OpenRemise/ESP32S3Board/bom.xlsx

 |  |  | ESP32S3Board PCS BOM
Item # | *Designator | *Qty | Manufacturer | *Mfg Part # | Description / Value | *Package/Footprint | Type | Your Instructions / Notes
1 | C1, C2, C5, C6, C7 | 5 | Samsung Electro-Mechanics | CL05B104KB54PNC | CAP CER 0.1UF 50V X7R 0402 | 0402 | SMD
2 | C3 | 1 | Nichicon | UCL1V101MCL6GS | CAP ALUM 100UF 20% 35V SMD | 6.60x6.60mm | SMD
3 | C4 | 1 | Samsung Electro-Mechanics | CL31B475KBHNFNE | CAP CER 4.7UF 50V X7R 1206 | 1206 | SMD
4 | C8, C9 | 2 | TDK Corporation | C3216X7S0J476M160AC | CAP CER 47UF 6.3V X7S 1206 | 1206 | SMD
5 | D1 | 1 | STMicroelectronics | ESDA6V1BC6 | TVS DIODE 5VWM SOT23-6 | SOT-23-6 | SMD
6 | D2 | 1 | SunLED | XZMDK68W-2 | LED RED CLEAR CHIP SMD | 0402 | SMD
7 | D3 | 1 | Toshiba Semiconductor and Storage | CEZ30V,L3F | TVS DIODE 30VWM 47.5VC ESC | SOD-523 | SMD
8 | D4 | 1 | SunLED | XZVG68W-2 | LED GREEN CLEAR CHIP SMD | 0402 | SMD
9 | D5 | 1 | SunLED | XZFBA68W5MAV-3 | LED BLUE CLEAR 0402 SMD | 0402 | SMD
10 | J1, J3, J4, J5, J6 | 5 |  |  |  |  | THT | not fitted
11 | J2 | 1 | GCT | USB4105-GF-A-120 | CONN RCP USB2.0 TYP C 24P SMD RA |  | SMD/THT
12 | J7 | 1 | JST Sales America Inc. | SM04B-SRSS-TB(LF)(SN) | CONN HEADER SMD R/A 4POS 1MM | 4-SMD | SMD
13 | JP1 | 1 |  |  |  |  | SMD | not fitted
14 | L1 | 1 | Murata Electronics | LQM21PN4R7NGRD | FIXED IND 4.7UH 800MA 288MOHM SM | 0805 | SMD
15 | Q1 | 1 | onsemi | BC847BDW1T1G | TRANS 2NPN 45V 0.1A SC88/SC70-6 | SOT-363 | SMD
16 | R1, R2 | 2 | Stackpole Electronics Inc | RMCF0402FT5K10 | RES 5.1K OHM 1% 1/16W 0402 | 0402 | SMD
17 | R3, R7, R8, R10 | 4 | Delta Electronics/Cyntec | PFR05S-103-FNH | RES SMD 10 KOHM 1% 1/16W 0402 | 0402 | SMD
18 | R4, R5 | 2 | Vishay Dale | TNPW040214K3BEED | RES 14.3K OHM 0.1% 1/16W 0402 | 0402 | SMD
19 | R6 | 1 | Panasonic Electronic Components | ERA-2AEB471X | RES SMD 470 OHM 0.1% 1/16W 0402 | 0402 | SMD
20 | R9, R11, R13 | 3 | TE Connectivity Passive Product | CRGCQ0402F3K3 | RES 3.3K OHM 1% 1/16W 0402 | 0402 | SMD
21 | R12 | 1 | YAGEO | RC0402FR-07562RL | RES 562 OHM 1% 1/16W 0402 | 0402 | SMD
22 | R14 | 1 | YAGEO | RC0402FR-07422RL | RES 422 OHM 1% 1/16W 0402 | 0402 | SMD
23 | SW1, SW2 | 2 | Panasonic Electronic Components | EVP-BFAC1A000 | SWITCH TACTILE SPST-NO 0.02A 15V |  | SMD | not fitted
24 | U1 | 1 | Espressif Systems | ESP32-S3-WROOM-2-N32R8V | SMD MODULE, ESP32-S3R8 WITH 1.8V |  | SMD
25 | U2 | 1 | Diodes Incorporated | AP63205WU-7 | IC REG BUCK 5V 2A TSOT26 | SOT-23-6 | SMD
26 | U3 | 1 | Texas Instruments | TXS0102DCUR | IC TRANSLTR BIDIRECTIONAL 8VSSOP | 8-VSSOP | SMD
27 | U4 | 1 | Infineon Technologies | BTS4141NHUMA1 | IC PWR SWTCH N-CHAN 1:1 SOT223-4 | SOT223-4 | SMD
28 | U5 | 1 | Diodes Incorporated | AZ1117CR-3.3TRG1 | IC REG LINEAR 3.3V 1A SOT89 | SOT-89-3 | SMD
