OpenRemise/ESP32S3Board/esp32s3board.kicad_pcb

## KiCad design esp32s3board.kicad_pcb (2024-08-15)

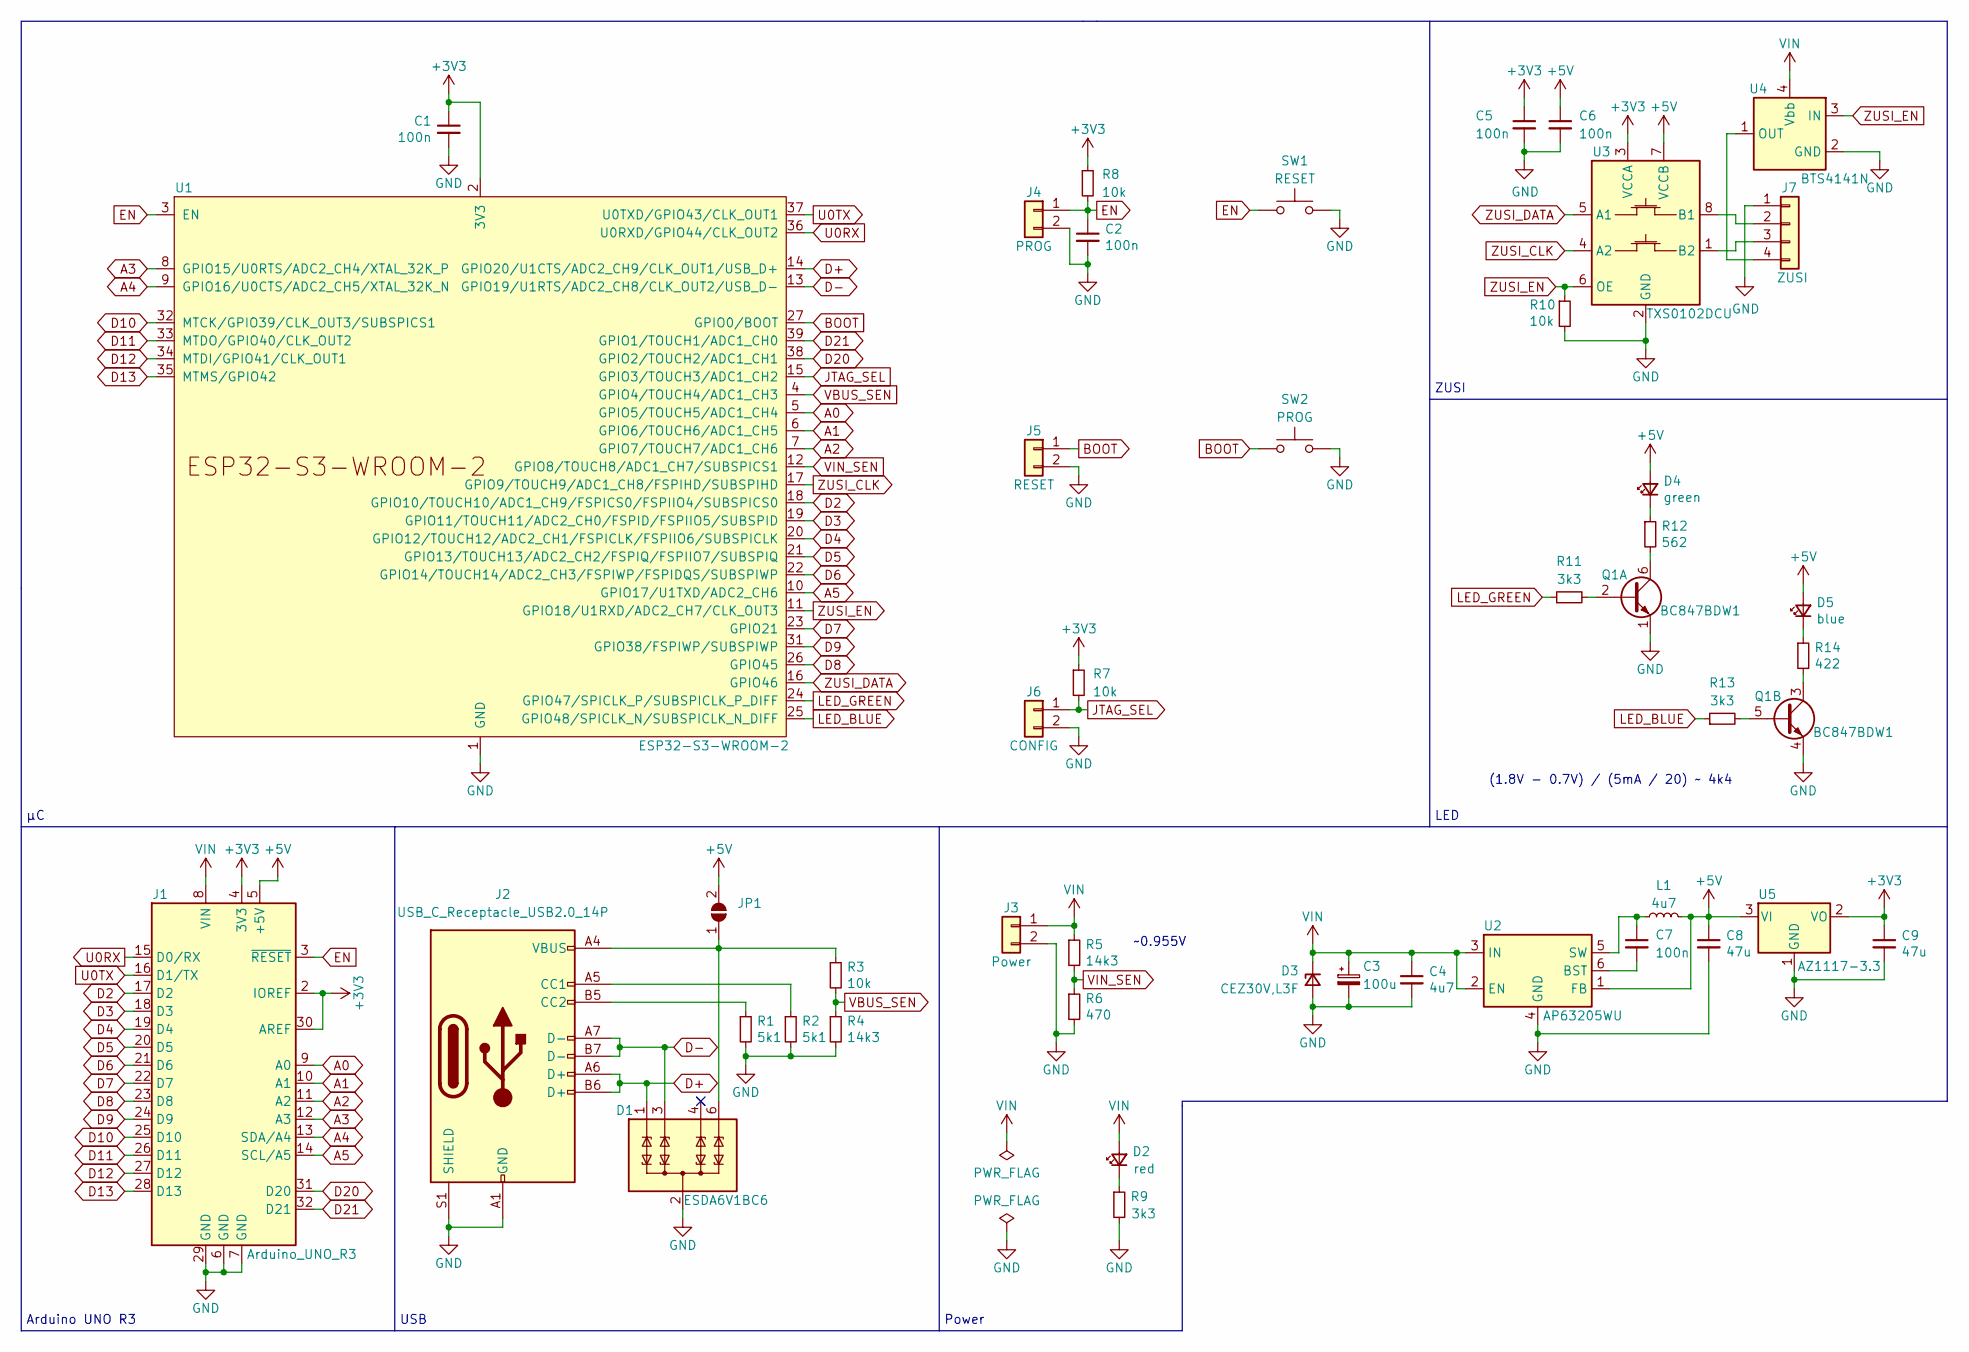
[picture p1: schematic esp32s3board.kicad_sch, OpenRemise ESP32S3Board]

Parts:
C1, C2, C5, C6, C7: 100n; C_0402_1005Metric
C3: 100u; CP_Elec_6.3x7.7
C4: 4u7; C_1206_3216Metric
C8, C9: 47u; C_1206_3216Metric
D1: ESDA6V1BC6; SOT-23-6
D2: red; D_0402_1005Metric
D3: CEZ30V,L3F; D_SOD-523
D4: green; D_0402_1005Metric
D5: blue; D_0402_1005Metric
J1: Arduino_UNO_R3; Arduino_UNO_R3_WithMountingHoles
J2: USB_C_Receptacle_USB2.0_14P; USB_C_Receptacle_GCT_USB4105-xx-A_16P_TopMnt_Horizontal
J3: Power; PinHeader_1x02_P2.54mm_Horizontal
J4: PROG; PinHeader_1x02_P2.54mm_Horizontal
J5: RESET; PinHeader_1x02_P2.54mm_Horizontal
J6: CONFIG; PinHeader_1x02_P2.54mm_Horizontal
J7: ZUSI; JST_SH_SM04B-SRSS-TB_1x04-1MP_P1.00mm_Horizontal
JP1: SolderJumper_2_Open; SolderJumper-2_P1.3mm_Open_Pad1.0x1.5mm
L1: 4u7; L_0805_2012Metric
Q1: BC847BDW1; SOT-363_SC-70-6
R1, R2: 5k1; R_0402_1005Metric
R3, R7, R8, R10: 10k; R_0402_1005Metric
R4, R5: 14k3; R_0402_1005Metric
R6: 470; R_0402_1005Metric
R9, R11, R13: 3k3; R_0402_1005Metric
R12: 562; R_0402_1005Metric
R14: 422; R_0402_1005Metric
SW1: RESET; SW_SPST_EVPBF
SW2: PROG; SW_SPST_EVPBF
U1: ESP32-S3-WROOM-2
U2: AP63205WU; TSOT-23-6
U3: TXS0102DCU; VSSOP-8_2.3x2mm_P0.5mm
U4: BTS4141N; SOT-223
U5: AZ1117-3.3; SOT-89-3

Connections:
+3V3: C1.1, C5.1, C9.1, J1.2 (IOREF), J1.4 (3V3), J1.30 (AREF), R7.1, R8.1, U1.2 (3V3), U3.3 (VCCA), U5.2 (VO)
+5V: C6.1, C8.1, D4.2 (A), D5.2 (A), J1.5 (+5V), JP1.2 (B), L1.2, U2.1 (FB), U3.7 (VCCB), U5.3 (VI)
A0: J1.9 (A0), U1.5 (GPIO5/TOUCH5/ADC1_CH4)
A1: J1.10 (A1), U1.6 (GPIO6/TOUCH6/ADC1_CH5)
A2: J1.11 (A2), U1.7 (GPIO7/TOUCH7/ADC1_CH6)
A3: J1.12 (A3), U1.8 (GPIO15/U0RTS/ADC2_CH4/XTAL_32K_P)
A4: J1.13 (SDA/A4), U1.9 (GPIO16/U0CTS/ADC2_CH5/XTAL_32K_N)
A5: J1.14 (SCL/A5), U1.10 (GPIO17/U1TXD/ADC2_CH6)
BOOT: J5.1, SW2.1, U1.27 (GPIO0/BOOT)
D2: J1.17 (D2), U1.18 (GPIO10/TOUCH10/ADC1_CH9/FSPICS0/FSPIIO4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)
D3: J1.18 (D3), U1.19 (GPIO11/TOUCH11/ADC2_CH0/FSPID/FSPIIO5/S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)
D4: J1.19 (D4), U1.20 (GPIO12/TOUCH12/ADC2_CH1/FSPICLK/FSPIIO6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)
D5: J1.20 (D5), U1.21 (GPIO13/TOUCH13/ADC2_CH2/FSPIQ/FSPIIO7/S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)
D6: J1.21 (D6), U1.22 (GPIO14/TOUCH14/ADC2_CH3/FSPIWP/FSPIDQS/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)
D7: J1.22 (D7), U1.23 (GPIO21)
D8: J1.23 (D8), U1.26 (GPIO45)
D9: J1.24 (D9), U1.31 (GPIO38/FSPIWP/SUBSPIWP)
D10: J1.25 (D10), U1.32 (MTCK/GPIO39/CLK_OUT3/SUBSPICS1)
D11: J1.26 (D11), U1.33 (MTDO/GPIO40/CLK_OUT2)
D12: J1.27 (D12), U1.34 (MTDI/GPIO41/CLK_OUT1)
D13: J1.28 (D13), U1.35 (MTMS/GPIO42)
D20: J1.31 (D20), U1.38 (GPIO2/TOUCH2/ADC1_CH1)
D21: J1.32 (D21), U1.39 (GPIO1/TOUCH1/ADC1_CH0)
D+: D1.1 (TVS1), J2.A6 (D+), J2.B6 (D+), U1.14 (GPIO20/U1CTS/ADC2_CH9/CLK_OUT1/USB_D+)
D-: D1.3 (TVS2), J2.A7 (D-), J2.B7 (D-), U1.13 (GPIO19/U1RTS/ADC2_CH8/CLK_OUT2/USB_D-)
EN: C2.1, J1.3 (~RESET), J4.1, R8.2, SW1.1, U1.3 (EN)
GND: C1.2, C2.2, C3.2, C4.2, C5.2, C6.2, C8.2, C9.2, D1.2 (COM), D1.5 (COM), D3.2 (A), J1.6 (GND), J1.7 (GND), J1.29 (GND), J2.A1 (GND), J2.A12 (GND), J2.B1 (GND), J2.B12 (GND), J2.S1 (SHIELD), J3.2, J4.2, J5.2, J6.2, J7.1, Q1.1 (E1), Q1.4 (E2), R1.2, R2.2, R4.2, R6.2, R9.2, R10.2, SW1.2, SW2.2, U1.1 (GND), U1.40 (GND), U1.41 (GND), U2.4 (GND), U3.2 (GND), U4.2 (GND), U5.1 (GND)
JTAG_SEL: J6.1, R7.2, U1.15 (GPIO3/TOUCH3/ADC1_CH2)
LED_BLUE: R13.1, U1.25 (GPIO48/SPICLK_N/SUBSPICLK_N_DIFF)
LED_GREEN: R11.1, U1.24 (GPIO47/SPICLK_P/SUBSPICLK_P_DIFF)
unnamed: D1.6 (TVS4), J2.A4 (VBUS), J2.A9 (VBUS), J2.B4 (VBUS), J2.B9 (VBUS), JP1.1 (A), R3.1
unnamed: D2.1 (K), R9.1
unnamed: D4.1 (K), R12.1
unnamed: D5.1 (K), R14.1
unnamed: J2.A5 (CC1), R2.1
unnamed: J2.B5 (CC2), R1.1
unnamed: J7.2, U3.8 (B1)
unnamed: J7.3, U3.1 (B2)
unnamed: J7.4, U4.1 (OUT)
unnamed: Q1.2 (B1), R11.2
unnamed: Q1.6 (C1), R12.2
unnamed: Q1.5 (B2), R13.2
unnamed: Q1.3 (C2), R14.2
unnamed: C7.2, U2.6 (BST)
unnamed: C7.1, L1.1, U2.5 (SW)
U0RX: J1.15 (D0/RX), U1.36 (U0RXD/GPIO44/CLK_OUT2)
U0TX: J1.16 (D1/TX), U1.37 (U0TXD/GPIO43/CLK_OUT1)
VBUS_SEN: R3.2, R4.1, U1.4 (GPIO4/TOUCH4/ADC1_CH3)
VIN: C3.1, C4.1, D2.2 (A), D3.1 (K), J1.8 (VIN), J3.1, R5.1, U2.2 (EN), U2.3 (IN), U4.4 (Vbb)
VIN_SEN: R5.2, R6.1, U1.12 (GPIO8/TOUCH8/ADC1_CH7/SUBSPICS1)
ZUSI_CLK: U1.17 (GPIO9/TOUCH9/ADC1_CH8/FSPIHD/SUBSPIHD), U3.4 (A2)
ZUSI_DATA: U1.16 (GPIO46), U3.5 (A1)
ZUSI_EN: R10.1, U1.11 (GPIO18/U1RXD/ADC2_CH7/CLK_OUT3), U3.6 (OE), U4.3 (IN)

Notes on the sheet:
(1.8V - 0.7V) / (5mA / 20) ~ 4k4
USB
ZUSI
~0.955V
Arduino UNO R3
LED
Power

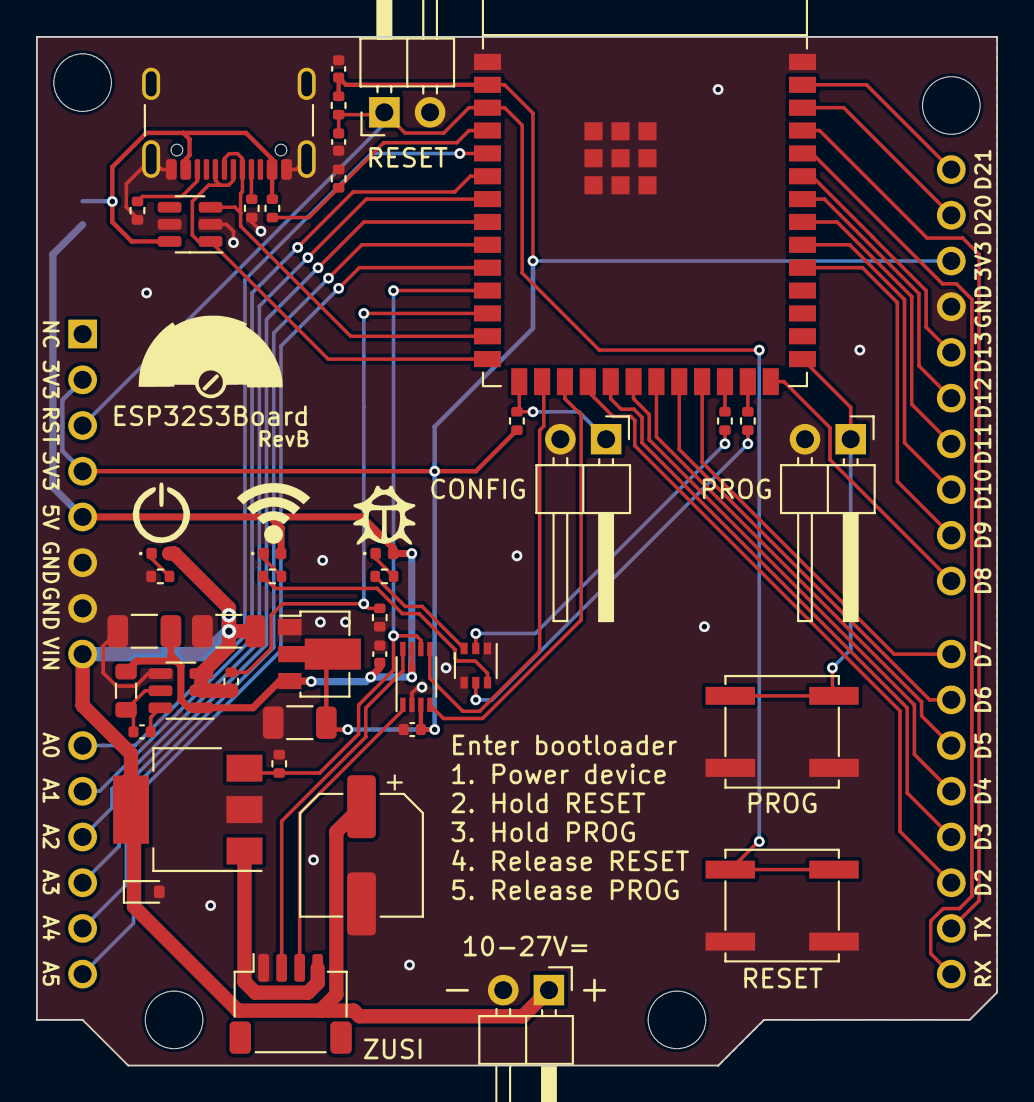
[picture p2: board esp32s3board.kicad_pcb from above]

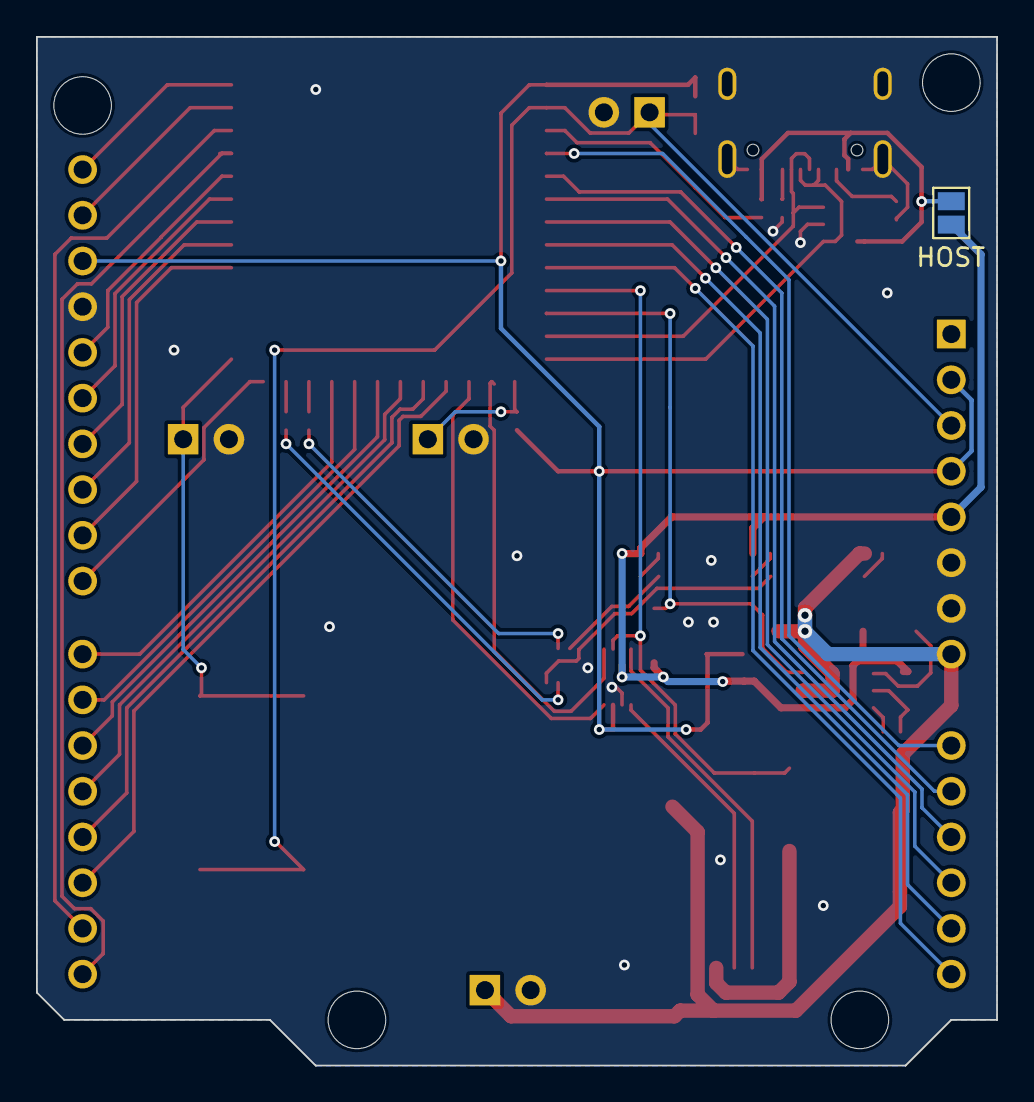
[picture p3: board esp32s3board.kicad_pcb from below]

Board: 2 copper layers, 53.3 x 57.2 mm, 45 parts (2 on the bottom side), 53 nets.
