OpenRemise/ESP32S3Board/(commit log)

2024-01-19 Switch to SMD USB plug
    [bom.xlsx, esp32s3board.kicad_pcb, esp32s3board.kicad_sch]
2024-01-19 Switch to horizontal pin headers
    [bom.xlsx, esp32s3board.kicad_pcb, esp32s3board.kicad_sch]
2024-08-15 chore: migrate to KiCad 8.0
    [esp32s3board.kicad_pcb, esp32s3board.kicad_sch]
